engineering-bay/LED_controller/00_Docs/enclosure.jpg

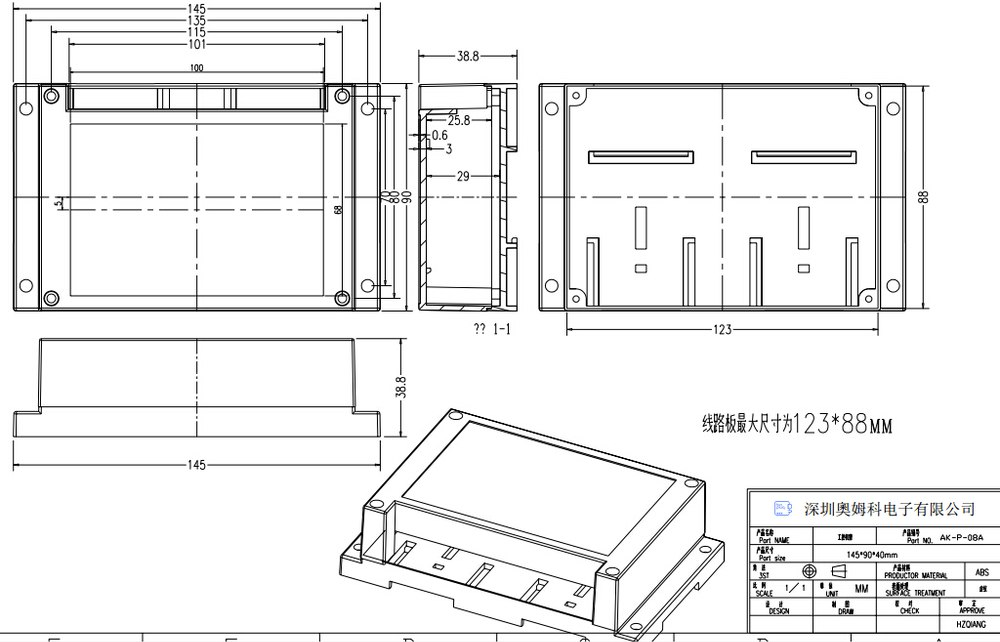
00_Docs/enclosure.jpg
