engineering-bay/LED_controller/02_Mechanics/pcb/texture_led_controller_top.png

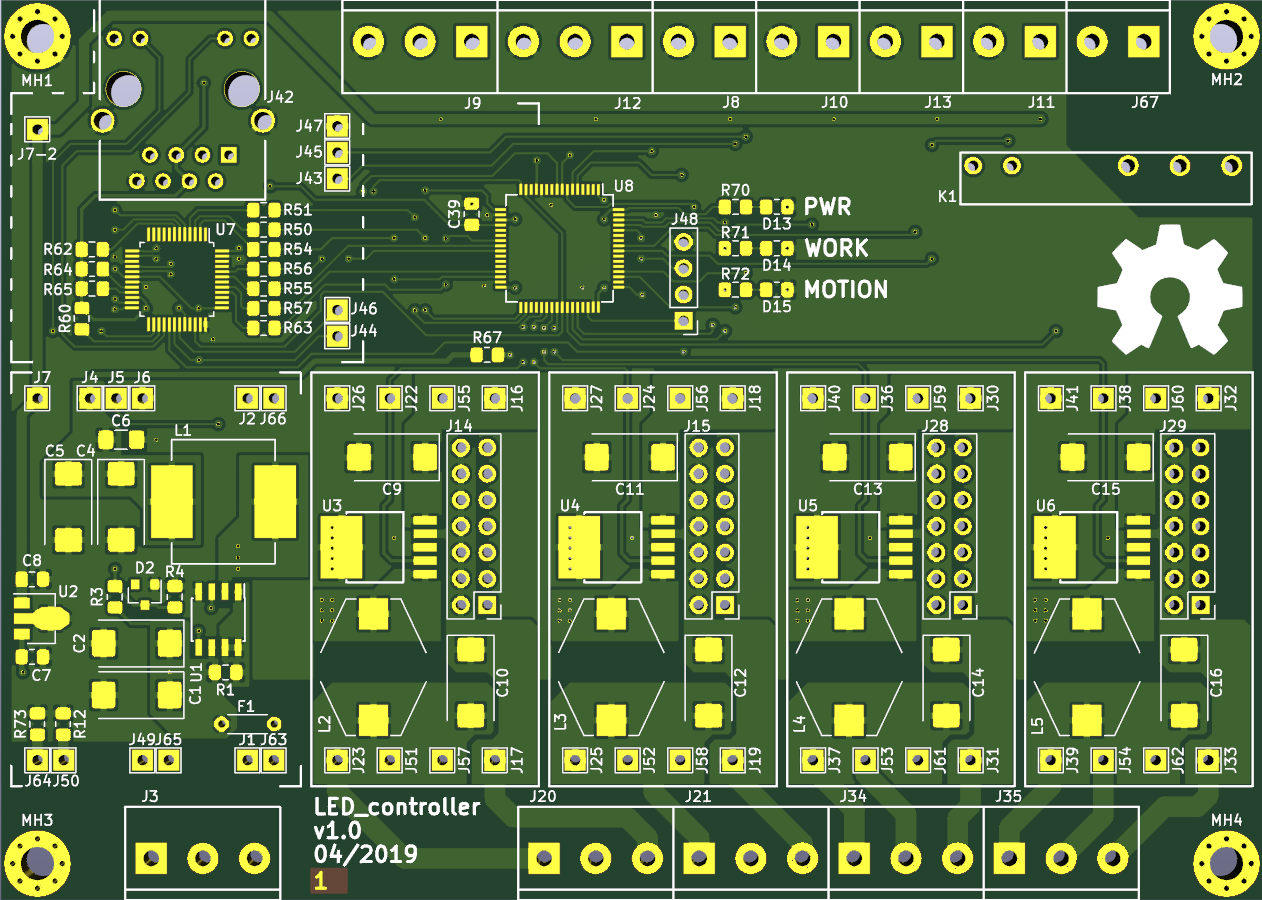
02_Mechanics/pcb/texture_led_controller_top.png
