engineering-bay/LED_controller/02_Mechanics/enclosure_top.SLDPRT

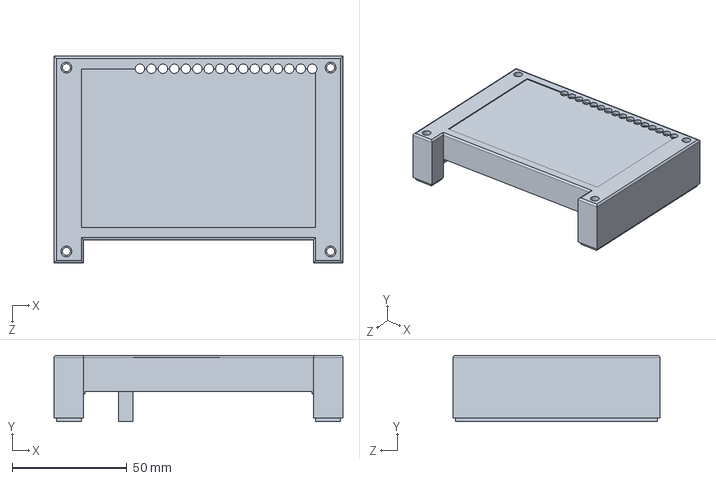
[picture p4: CAD file, 2019-04-28]
02_Mechanics/enclosure_top.SLDPRT
125.8 x 28.8 x 90.0 mm
