engineering-bay/LED_controller/02_Mechanics/enclosure_bottom.SLDPRT

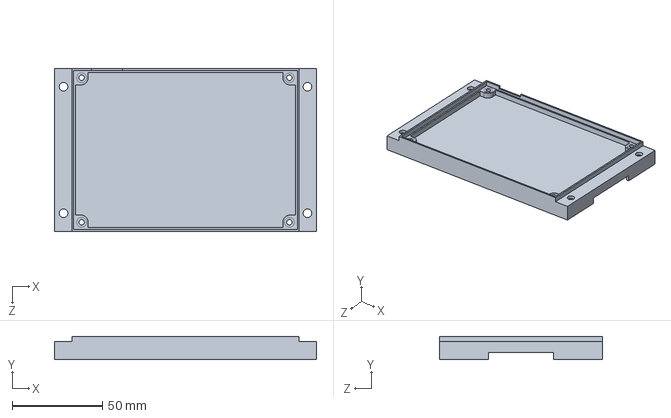
[picture p5: CAD file, 2019-04-28]
02_Mechanics/enclosure_bottom.SLDPRT
145.0 x 13.0 x 90.0 mm
