engineering-bay/LED_controller/01_Schematics/LED_controller/LED_controller.kicad_pcb

## KiCad design 01_Schematics/LED_controller/LED_controller.kicad_pcb (2019-07-31)

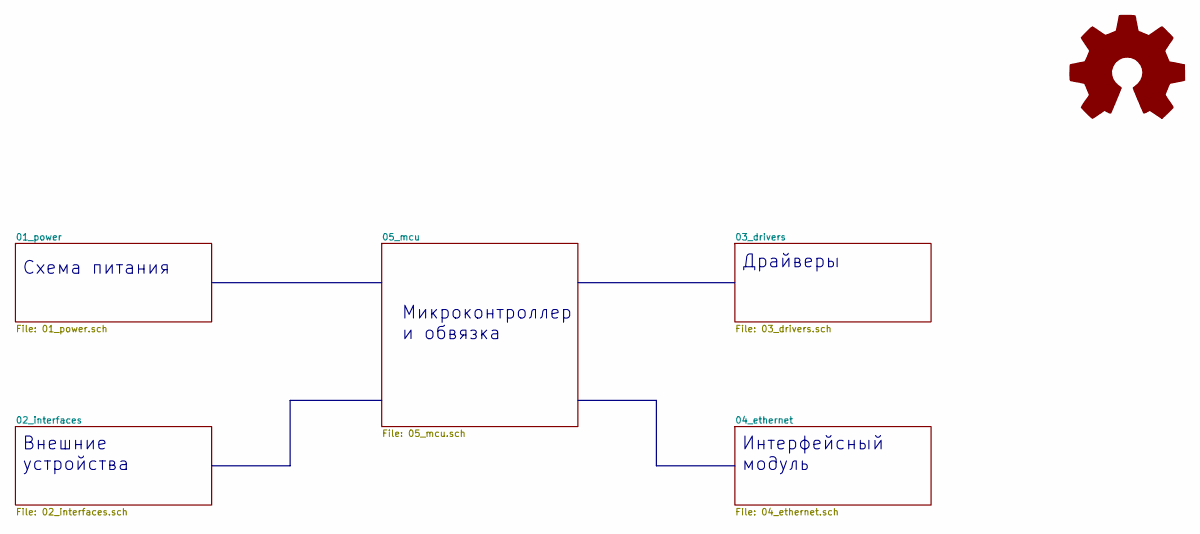
[picture p7: schematic LED_controller.sch, LED controller]

Notes on the sheet:
Схема питания
Микроконтроллер и обвязка
Внешние устройства
Интерфейсный модуль
Драйверы

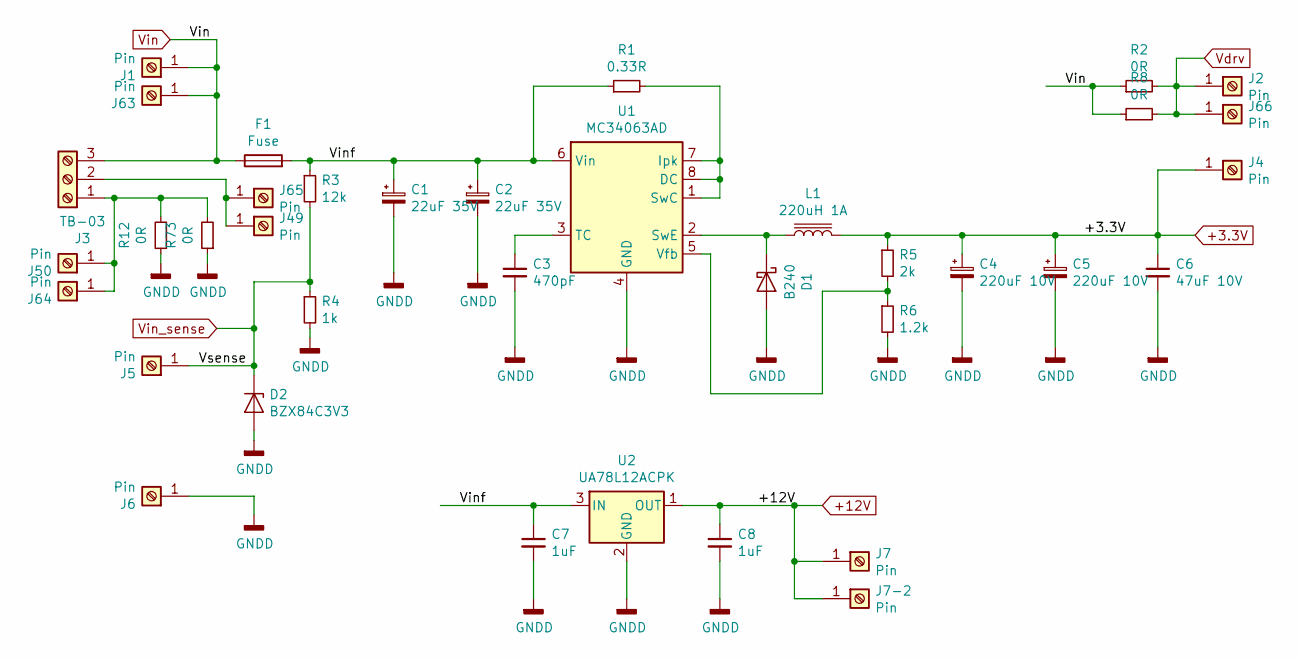
[picture p8: schematic 01_power.sch]

Parts:
C1, C2: 22uF 35V; CP_EIA-7343-31_Kemet-D_Pad2.25x2.55mm_HandSolder; partnum 293D226X9035D2TE3
C3: 470pF; C_0805_2012Metric_Pad1.15x1.40mm_HandSolder; partnum CC0805JRNPO9BN471
C4, C5: 220uF 10V; CP_EIA-7343-31_Kemet-D_Pad2.25x2.55mm_HandSolder; partnum 293D227X9010D2TE3
C6: 47uF 10V; C_1206_3216Metric_Pad1.42x1.75mm_HandSolder; partnum GRM31CR61A476ME15L
C7, C8: 1uF; C_0805_2012Metric_Pad1.15x1.40mm_HandSolder; partnum CC0805KKX7R9BB105
D1: B240; D_SMB
D2: BZX84C3V3; D_SOT-23_ANK
F1: Fuse; MF-R185; partnum MF-R090
J1, J2, J4, J5, J6, J7, J7-2, J49, J50, J63, J64, J65, J66: Pin; TestPoint_THTPad_2.0x2.0mm_Drill1.0mm
J3: TB-03; TB-03_metric; partnum TB-03
L1: 220uH 1A; SRR1208; partnum SRR1208-221KL
R1: 0.33R; R_0805_2012Metric_Pad1.15x1.40mm_HandSolder; partnum RL0805FR-070R33L
R2, R8, R12, R73: 0R; R_0805_2012Metric_Pad1.15x1.40mm_HandSolder; partnum RC2010JK-070RL
R3: 12k; R_0805_2012Metric_Pad1.15x1.40mm_HandSolder; partnum RC0805FR-0712KL
R4: 1k; R_0805_2012Metric_Pad1.15x1.40mm_HandSolder; partnum RC0805FR-071KL
R5: 2k; R_0805_2012Metric_Pad1.15x1.40mm_HandSolder; partnum RC0805FR-072KL
R6: 1.2k; R_0805_2012Metric_Pad1.15x1.40mm_HandSolder; partnum RC0805FR-071K2L
U1: MC34063AD; SOIC-8_3.9x4.9mm_P1.27mm
U2: UA78L12ACPK; SOT-89-3; partnum UA78L12ACPK

Connections:
+3.3V: C4.1, C5.1, C6.1, J4.1, L1.2, R5.1; also elsewhere on the board
+12V: C8.1, J7.1, J7-2.1, U2.1 (OUT); also elsewhere on the board
/01_power/Vinf: C1.1, C2.1, C7.1, F1.2, R1.1, R3.1, U1.6 (Vin), U2.3 (IN)
GND: C1.2, C2.2, C3.2, C4.2, C5.2, C6.2, C7.2, C8.2, D1.2 (A), D2.2 (A), J6.1, R4.2, R6.2, R12.1, R73.1, U1.4 (GND), U2.2 (GND); also elsewhere on the board
unnamed: C3.1, U1.3 (TC)
unnamed: D1.1 (K), L1.1, U1.2 (SwE)
unnamed: J3.1, J50.1, J64.1, R12.2, R73.2
unnamed: J3.2, J49.1, J65.1
unnamed: R1.2, U1.1 (SwC), U1.7 (Ipk), U1.8 (DC)
unnamed: R5.2, R6.1, U1.5 (Vfb)
Vdrv: J2.1, J66.1, R2.2, R8.2; also elsewhere on the board
Vin: F1.1, J1.1, J3.3, J63.1, R2.1, R8.1
Vin_sense: D2.1 (K), J5.1, R3.2, R4.1; also elsewhere on the board

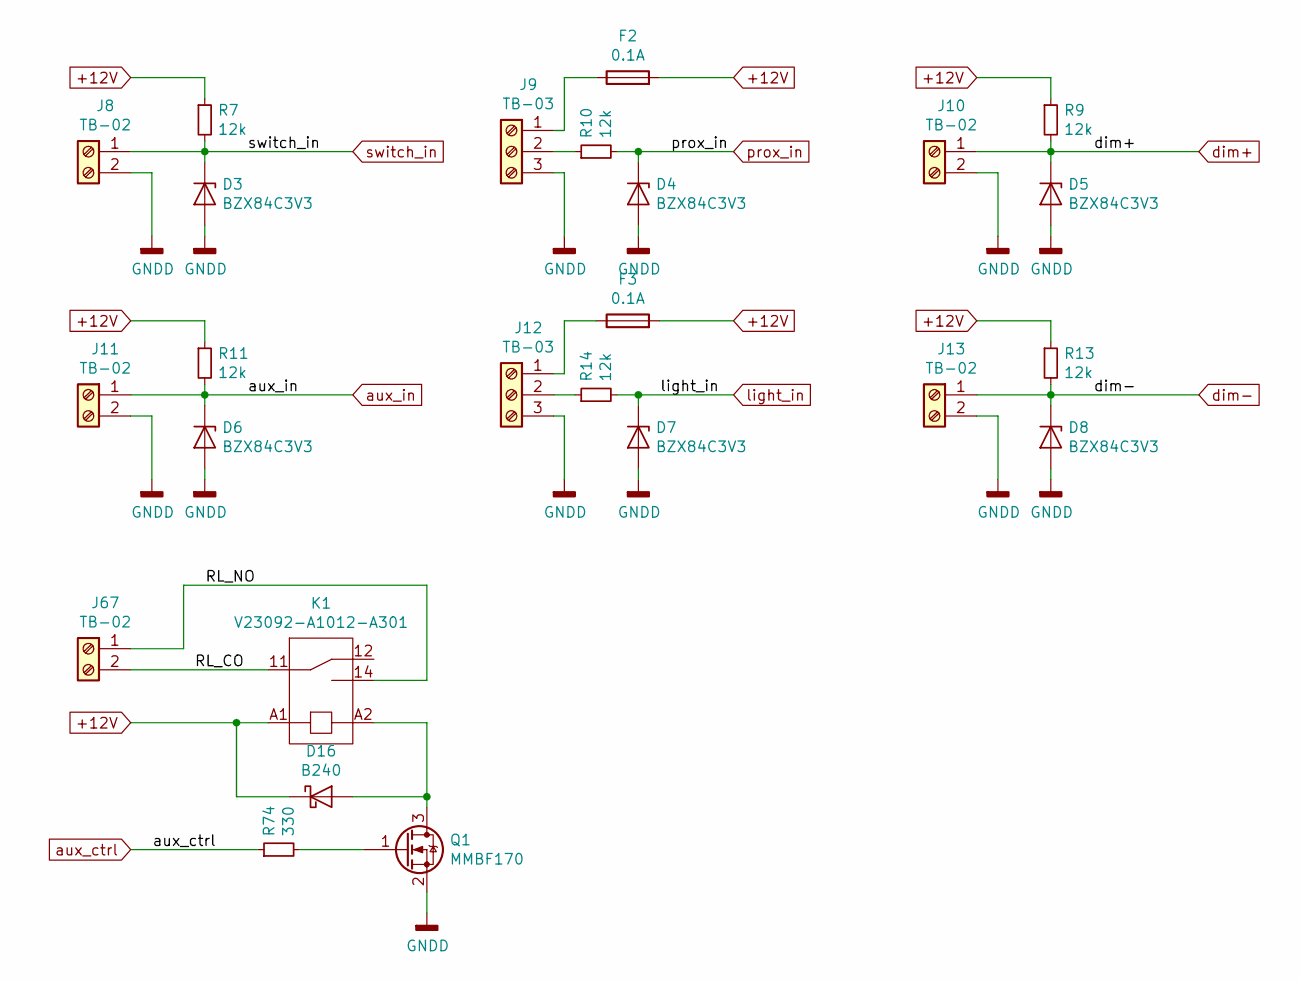
[picture p9: schematic 02_interfaces.sch]

Parts:
D3, D4, D5, D6, D7, D8: BZX84C3V3; D_SOT-23_ANK
D16: B240; D_SMB
F2, F3: 0.1A; R_1812_4532Metric_Pad1.30x3.40mm_HandSolder; partnum MF-MSMF010
J8, J10, J11, J13, J67: TB-02; TB-02_metric; partnum 300-021-12
J9, J12: TB-03; TB-03_metric; partnum 300-031-12
K1: V23092-A1012-A301; Relay_TE_V23092
Q1: MMBF170; SOT-23
R7, R9, R10, R11, R13, R14: 12k; R_0805_2012Metric_Pad1.15x1.40mm_HandSolder; partnum RC0805FR-0712KL
R74: 330; R_0805_2012Metric_Pad1.15x1.40mm_HandSolder; partnum RC0805FR-07330RL

Connections:
+12V: D16.1 (K), F2.2, F3.2, K1.A1, R7.1, R9.1, R11.1, R13.1; also elsewhere on the board
/02_interfaces/RL_CO: J67.2, K1.11
/02_interfaces/RL_NO: J67.1, K1.14
GND: D3.2 (A), D4.2 (A), D5.2 (A), D6.2 (A), D7.2 (A), D8.2 (A), J8.2, J9.3, J10.2, J11.2, J12.3, J13.2, Q1.2 (S); also elsewhere on the board
unnamed: D16.2 (A), K1.A2, Q1.3 (D)
unnamed: F2.1, J9.1
unnamed: F3.1, J12.1
unnamed: J9.2, R10.1
unnamed: J12.2, R14.1
unnamed: Q1.1 (G), R74.2
aux_ctrl: R74.1; also elsewhere on the board
aux_in: D6.1 (K), J11.1, R11.2; also elsewhere on the board
dim+: D5.1 (K), J10.1, R9.2; also elsewhere on the board
dim-: D8.1 (K), J13.1, R13.2; also elsewhere on the board
light_in: D7.1 (K), R14.2; also elsewhere on the board
prox_in: D4.1 (K), R10.2; also elsewhere on the board
switch_in: D3.1 (K), J8.1, R7.2; also elsewhere on the board

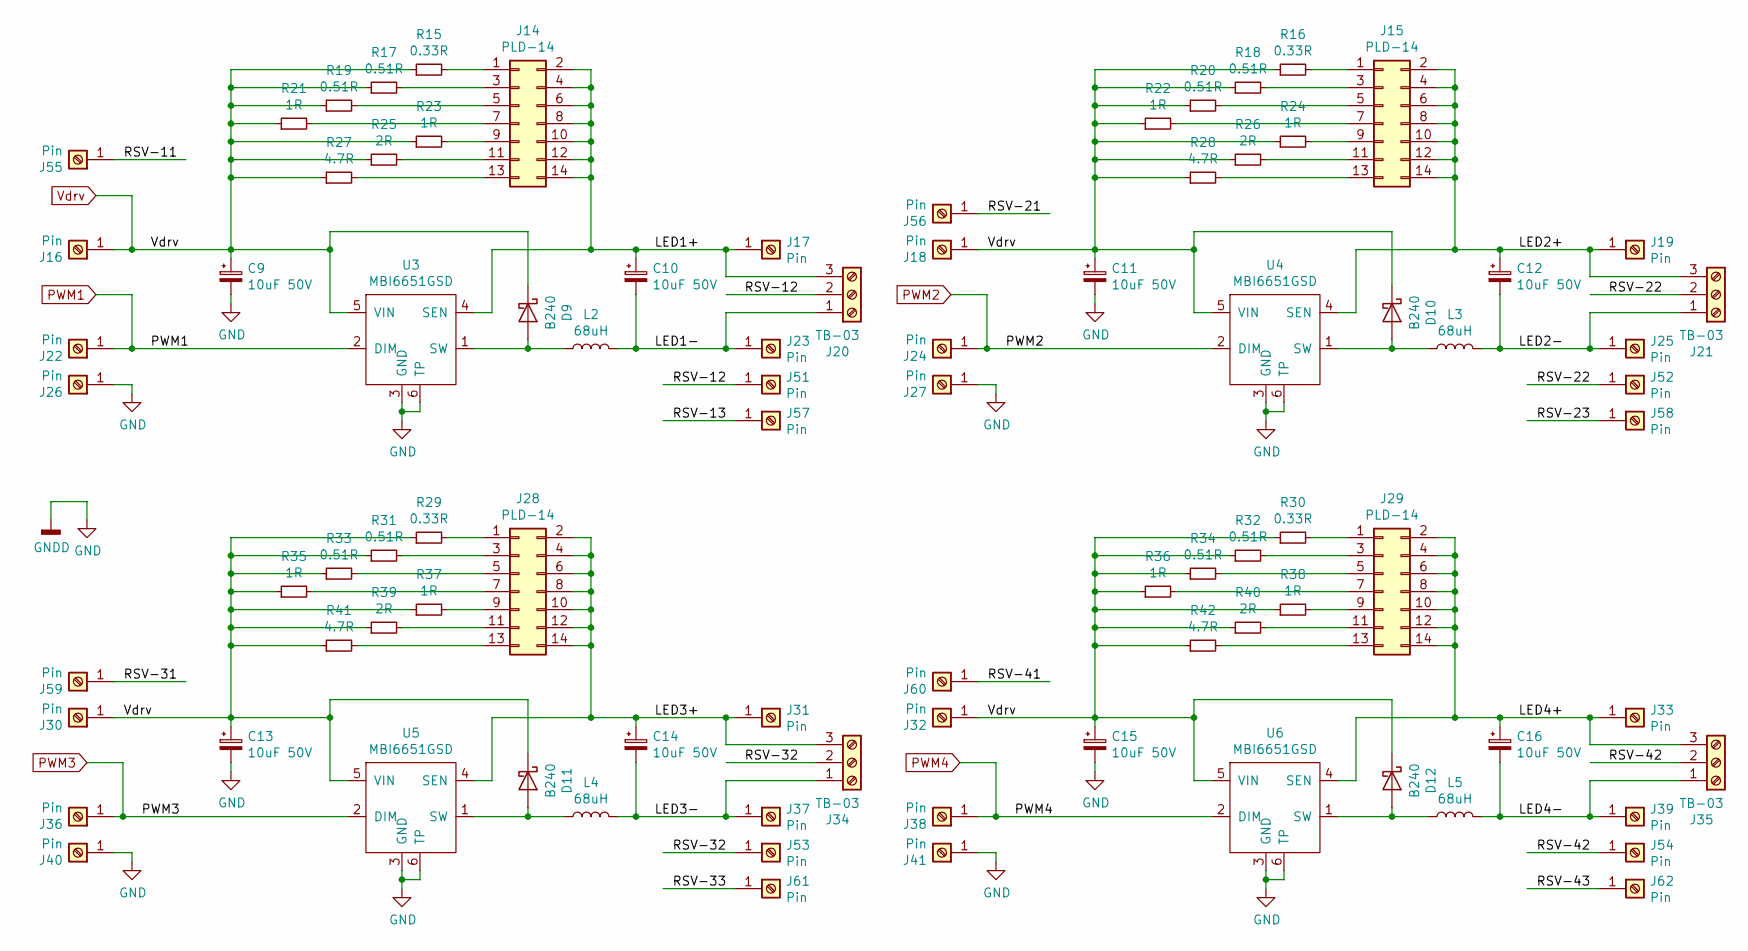
[picture p10: schematic 03_drivers.sch]

Parts:
C9, C10, C11, C12, C13, C14, C15, C16: 10uF 50V; CP_EIA-7343-31_Kemet-D_Pad2.25x2.55mm_HandSolder; partnum 293D106X9035D2TE3
D9, D10, D11, D12: B240; D_SMB
J14, J15, J28, J29: PLD-14; PinHeader_2x07_P2.54mm_Vertical; partnum PLD-14
J16, J17, J18, J19, J22, J23, J24, J25, J26, J27, J30, J31, J32, J33, J36, J37, J38, J39, J40, J41, J51, J52, J53, J54, J55, J56, J57, J58, J59, J60, J61, J62: Pin; TestPoint_THTPad_2.0x2.0mm_Drill1.0mm
J20, J21, J34, J35: TB-03; TB-03_metric; partnum TB-03
L2, L3, L4, L5: 68uH; L_Bourns-SRR1005
R15, R16, R29, R30: 0.33R; R_0805_2012Metric_Pad1.15x1.40mm_HandSolder; partnum RL0805FR-070R33L
R17, R18, R19, R20, R31, R32, R33, R34: 0.51R; R_0805_2012Metric_Pad1.15x1.40mm_HandSolder; partnum RL0805FR-070R51L
R21, R22, R23, R24, R35, R36, R37, R38: 1R; R_0805_2012Metric_Pad1.15x1.40mm_HandSolder; partnum RC0805FR-071RL
R25, R26, R39, R40: 2R; R_0805_2012Metric_Pad1.15x1.40mm_HandSolder; partnum RC0805FR-072RL
R27, R28, R41, R42: 4.7R; R_0805_2012Metric_Pad1.15x1.40mm_HandSolder; partnum RC0805FR-074R7L
U3, U4, U5, U6: MBI6651GSD; TO-252-5L; partnum MBI6651GSD-A

Connections:
/03_drivers/LED1+: C10.1, J14.2, J14.4, J14.6, J14.8, J14.10, J14.12, J14.14, J17.1, J20.3, U3.4 (SEN)
/03_drivers/LED1-: C10.2, J20.1, J23.1, L2.2
/03_drivers/LED2+: C12.1, J15.2, J15.4, J15.6, J15.8, J15.10, J15.12, J15.14, J19.1, J21.3, U4.4 (SEN)
/03_drivers/LED2-: C12.2, J21.1, J25.1, L3.2
/03_drivers/LED3+: C14.1, J28.2, J28.4, J28.6, J28.8, J28.10, J28.12, J28.14, J31.1, J34.3, U5.4 (SEN)
/03_drivers/LED3-: C14.2, J34.1, J37.1, L4.2
/03_drivers/LED4+: C16.1, J29.2, J29.4, J29.6, J29.8, J29.10, J29.12, J29.14, J33.1, J35.3, U6.4 (SEN)
/03_drivers/LED4-: C16.2, J35.1, J39.1, L5.2
/03_drivers/RSV-11: J55.1
/03_drivers/RSV-12: J20.2, J51.1
/03_drivers/RSV-13: J57.1
/03_drivers/RSV-21: J56.1
/03_drivers/RSV-22: J21.2, J52.1
/03_drivers/RSV-23: J58.1
/03_drivers/RSV-31: J59.1
/03_drivers/RSV-32: J34.2, J53.1
/03_drivers/RSV-33: J61.1
/03_drivers/RSV-41: J60.1
/03_drivers/RSV-42: J35.2, J54.1
/03_drivers/RSV-43: J62.1
GND: C9.2, C11.2, C13.2, C15.2, J26.1, J27.1, J40.1, J41.1, U3.3 (GND), U3.6 (TP), U4.3 (GND), U4.6 (TP), U5.3 (GND), U5.6 (TP), U6.3 (GND), U6.6 (TP); also elsewhere on the board
unnamed: D9.2 (A), L2.1, U3.1 (SW)
unnamed: D10.2 (A), L3.1, U4.1 (SW)
unnamed: D11.2 (A), L4.1, U5.1 (SW)
unnamed: D12.2 (A), L5.1, U6.1 (SW)
unnamed: J14.1, R15.2
unnamed: J14.3, R17.2
unnamed: J14.5, R19.2
unnamed: J14.7, R21.2
unnamed: J14.9, R23.2
unnamed: J14.11, R25.2
unnamed: J14.13, R27.2
unnamed: J15.1, R16.2
unnamed: J15.3, R18.2
unnamed: J15.5, R20.2
unnamed: J15.7, R22.2
unnamed: J15.9, R24.2
unnamed: J15.11, R26.2
unnamed: J15.13, R28.2
unnamed: J28.1, R29.2
unnamed: J28.3, R31.2
unnamed: J28.5, R33.2
unnamed: J28.7, R35.2
unnamed: J28.9, R37.2
unnamed: J28.11, R39.2
unnamed: J28.13, R41.2
unnamed: J29.1, R30.2
unnamed: J29.3, R32.2
unnamed: J29.5, R34.2
unnamed: J29.7, R36.2
unnamed: J29.9, R38.2
unnamed: J29.11, R40.2
unnamed: J29.13, R42.2
PWM1: J22.1, U3.2 (DIM); also elsewhere on the board
PWM2: J24.1, U4.2 (DIM); also elsewhere on the board
PWM3: J36.1, U5.2 (DIM); also elsewhere on the board
PWM4: J38.1, U6.2 (DIM); also elsewhere on the board
Vdrv: C9.1, C11.1, C13.1, C15.1, D9.1 (K), D10.1 (K), D11.1 (K), D12.1 (K), J16.1, J18.1, J30.1, J32.1, R15.1, R16.1, R17.1, R18.1, R19.1, R20.1, R21.1, R22.1, R23.1, R24.1, R25.1, R26.1, R27.1, R28.1, R29.1, R30.1, R31.1, R32.1, R33.1, R34.1, R35.1, R36.1, R37.1, R38.1, R39.1, R40.1, R41.1, R42.1, U3.5 (VIN), U4.5 (VIN), U5.5 (VIN), U6.5 (VIN); also elsewhere on the board

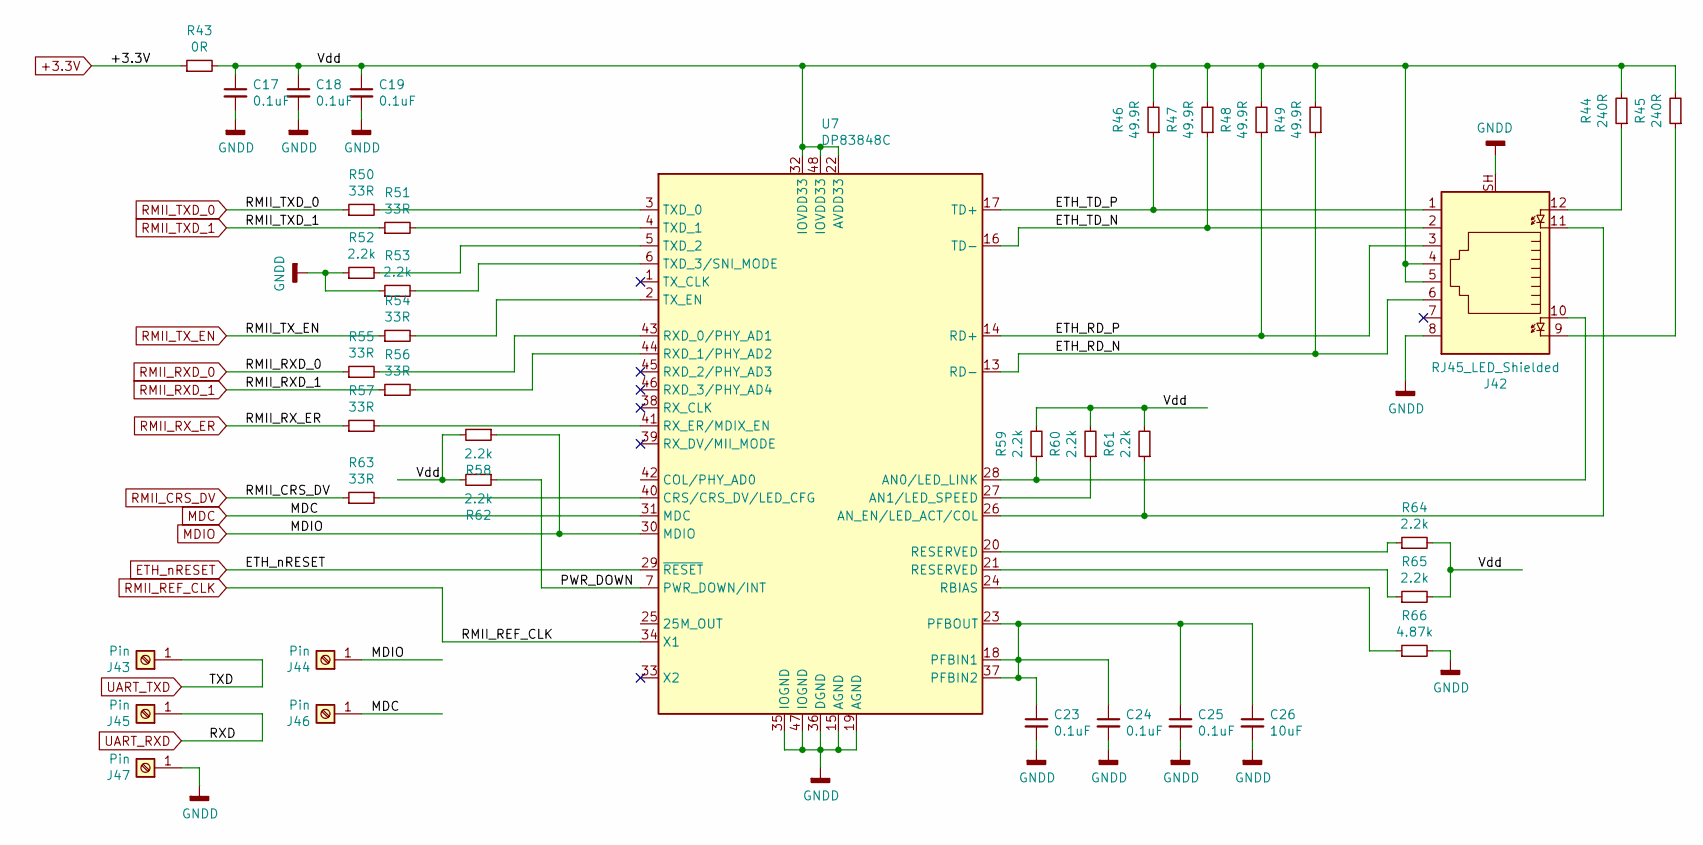
[picture p11: schematic 04_ethernet.sch]

Parts:
C17, C18, C19, C23, C24, C25: 0.1uF; C_0805_2012Metric_Pad1.15x1.40mm_HandSolder; partnum CC0805JRX7R9BB104
C26: 10uF; C_0805_2012Metric_Pad1.15x1.40mm_HandSolder; partnum GRM21BR61C106KE15L
J42: RJ45_LED_Shielded; Hanrun_HR9111105A; partnum HR911105A
J43, J44, J45, J46, J47: Pin; TestPoint_THTPad_2.0x2.0mm_Drill1.0mm
R43: 0R; R_0805_2012Metric_Pad1.15x1.40mm_HandSolder; partnum RC2010JK-070RL
R44, R45: 240R; R_0805_2012Metric_Pad1.15x1.40mm_HandSolder; partnum RC0805FR-07240RL
R46, R47, R48, R49: 49.9R; R_0805_2012Metric_Pad1.15x1.40mm_HandSolder; partnum RC0805FR-0749R9L
R50, R51, R54, R55, R56, R57, R63: 33R; R_0805_2012Metric_Pad1.15x1.40mm_HandSolder; partnum RC0805FR-0733RL
R52, R53, R58, R59, R60, R61, R62, R64, R65: 2.2k; R_0805_2012Metric_Pad1.15x1.40mm_HandSolder; partnum RC0805FR-072K2L
R66: 4.87k; R_0805_2012Metric_Pad1.15x1.40mm_HandSolder; partnum RC0805FR-074K87L
U7: DP83848C; LQFP-48_7x7mm_P0.5mm

Connections:
+3.3V: R43.1; also elsewhere on the board
/04_ethernet/ETH_RD_N: J42.6, R49.1, U7.13 (RD-)
/04_ethernet/ETH_RD_P: J42.3, R48.1, U7.14 (RD+)
/04_ethernet/ETH_TD_N: J42.2, R47.1, U7.16 (TD-)
/04_ethernet/ETH_TD_P: J42.1, R46.1, U7.17 (TD+)
/04_ethernet/PWR_DOWN: R62.1, U7.7 (PWR_DOWN/INT)
/04_ethernet/Vdd: C17.1, C18.1, C19.1, J42.4, J42.5, R43.2, R44.2, R45.2, R46.2, R47.2, R48.2, R49.2, R58.2, R59.2, R60.2, R61.2, R62.2, R64.2, R65.2, U7.22 (AVDD33), U7.32 (IOVDD33), U7.48 (IOVDD33)
ETH_nRESET: U7.29 (~RESET~); also elsewhere on the board
GND: C17.2, C18.2, C19.2, C23.2, C24.2, C25.2, C26.2, J42.8, J42.SH, J47.1, R52.1, R53.1, R66.2, U7.15 (AGND), U7.19 (AGND), U7.35 (IOGND), U7.36 (DGND), U7.47 (IOGND); also elsewhere on the board
MDC: J46.1, U7.31 (MDC); also elsewhere on the board
MDIO: J44.1, R58.1, U7.30 (MDIO); also elsewhere on the board
unnamed: C23.1, C24.1, C25.1, C26.1, U7.18 (PFBIN1), U7.23 (PFBOUT), U7.37 (PFBIN2)
unnamed: J42.9, R45.1
unnamed: J42.10, R59.1, U7.28 (AN0/LED_LINK)
unnamed: J42.11, R61.1, U7.26 (AN_EN/LED_ACT/COL)
unnamed: J42.12, R44.1
unnamed: R50.2, U7.3 (TXD_0)
unnamed: R51.2, U7.4 (TXD_1)
unnamed: R52.2, U7.5 (TXD_2)
unnamed: R53.2, U7.6 (TXD_3/SNI_MODE)
unnamed: R54.2, U7.2 (TX_EN)
unnamed: R55.2, U7.43 (RXD_0/PHY_AD1)
unnamed: R56.2, U7.44 (RXD_1/PHY_AD2)
unnamed: R57.2, U7.41 (RX_ER/MDIX_EN)
unnamed: R60.1, U7.27 (AN1/LED_SPEED)
unnamed: R63.2, U7.40 (CRS/CRS_DV/LED_CFG)
unnamed: R64.1, U7.20 (RESERVED)
unnamed: R65.1, U7.21 (RESERVED)
unnamed: R66.1, U7.24 (RBIAS)
RMII_CRS_DV: R63.1; also elsewhere on the board
RMII_REF_CLK: U7.34 (X1); also elsewhere on the board
RMII_RXD_0: R55.1; also elsewhere on the board
RMII_RXD_1: R56.1; also elsewhere on the board
RMII_RX_ER: R57.1; also elsewhere on the board
RMII_TXD_0: R50.1; also elsewhere on the board
RMII_TXD_1: R51.1; also elsewhere on the board
RMII_TX_EN: R54.1; also elsewhere on the board
UART_RXD: J45.1; also elsewhere on the board
UART_TXD: J43.1; also elsewhere on the board

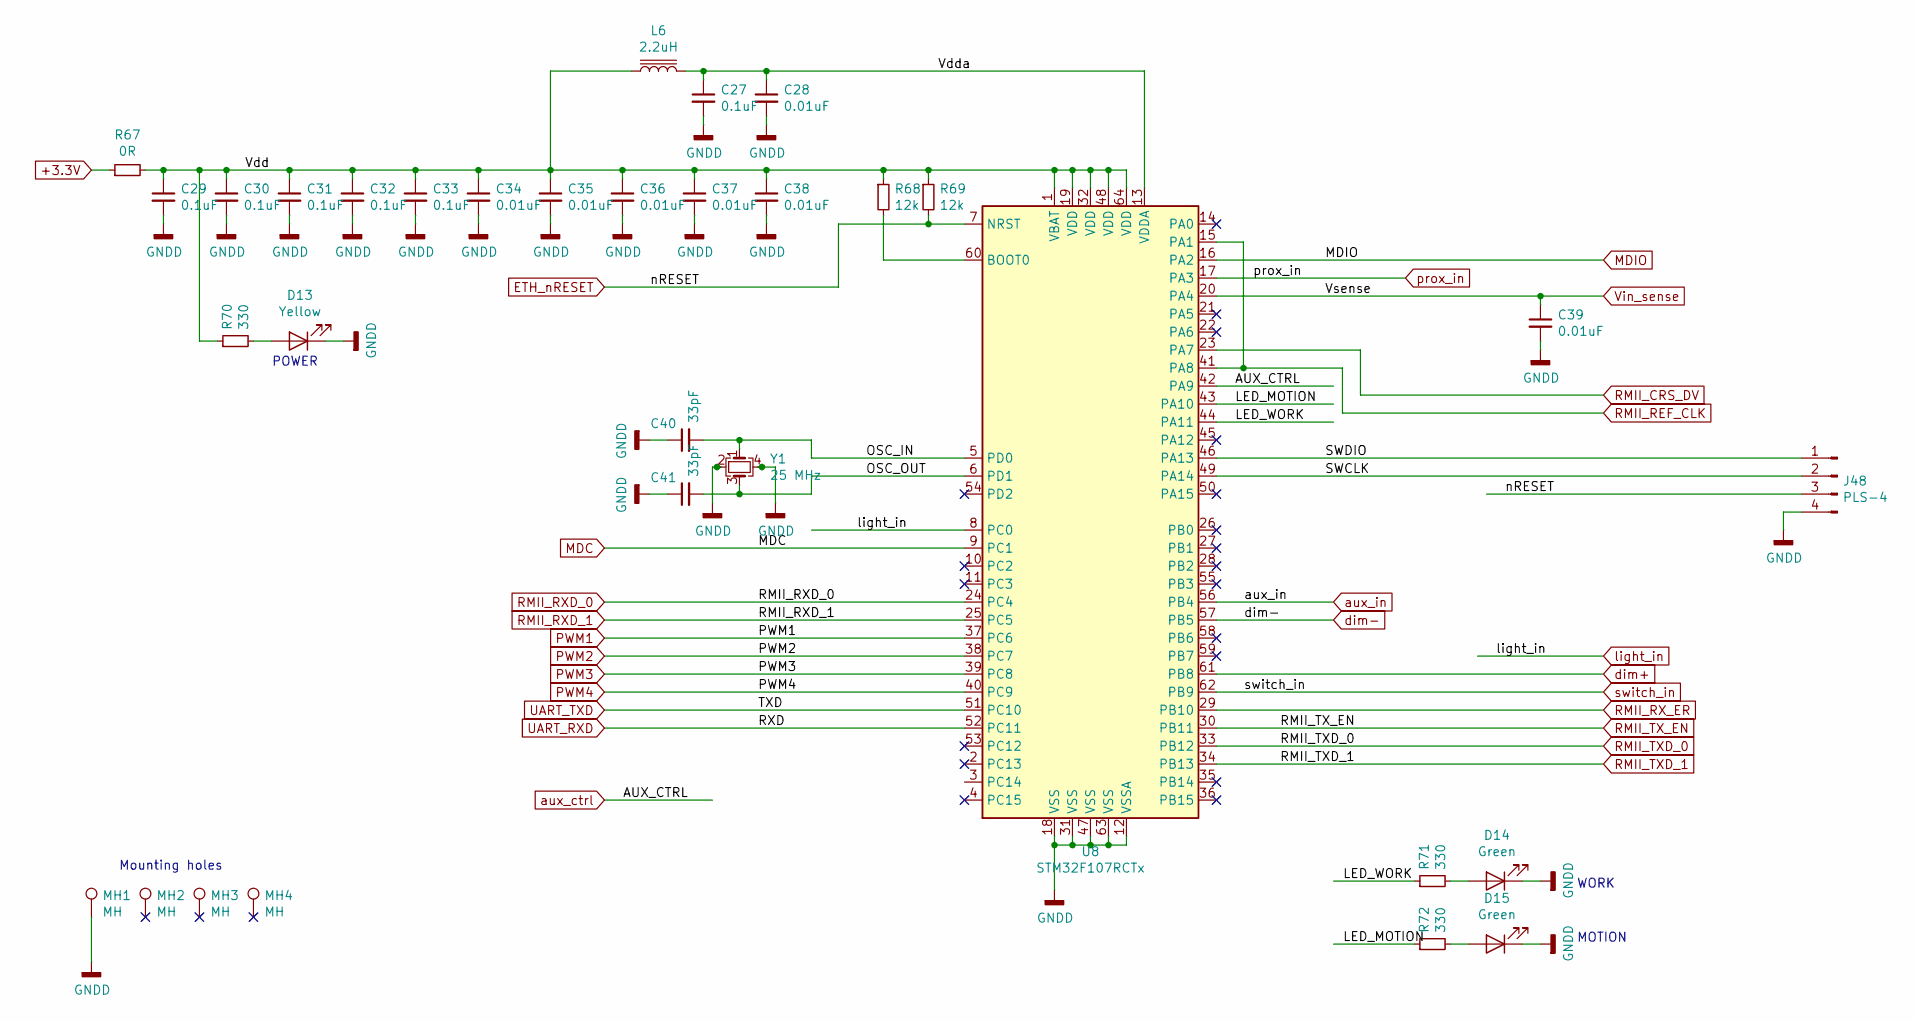
[picture p12: schematic 05_mcu.sch]

Parts:
C27, C29, C30, C31, C32, C33: 0.1uF; C_0805_2012Metric_Pad1.15x1.40mm_HandSolder; partnum CC0805JRX7R9BB104
C28, C34, C35, C36, C37, C38, C39: 0.01uF; C_0805_2012Metric_Pad1.15x1.40mm_HandSolder; partnum CC0805JRNPO9BN103
C40, C41: 33pF; C_0805_2012Metric_Pad1.15x1.40mm_HandSolder; partnum CC0805JRNPO9BN330
D13: Yellow; LED_0805_2012Metric_HandSolder; partnum TO-2013BC-MYF
D14, D15: Green; LED_0805_2012Metric_HandSolder; partnum TO-2013BC-PG
J48: PLS-4; PinHeader_1x04_P2.54mm_Vertical; partnum PLS-4
L6: 2.2uH; L_0805_2012Metric_Pad1.15x1.40mm_HandSolder; partnum B82498F1222J000
MH1, MH2, MH3, MH4: MH; MountingHole_3.2mm_M3_Pad_Via
R67: 0R; R_0805_2012Metric_Pad1.15x1.40mm_HandSolder; partnum RC2010JK-070RL
R68, R69: 12k; R_0805_2012Metric_Pad1.15x1.40mm_HandSolder; partnum RC0805FR-0712KL
R70, R71, R72: 330; R_0805_2012Metric_Pad1.15x1.40mm_HandSolder; partnum RC0805FR-07330RL
U8: STM32F107RCTx; LQFP-64_10x10mm_P0.5mm; partnum STM32F107RCTx
Y1: 25 MHz; Crystal_SMD_3225-4Pin_3.2x2.5mm_HandSoldering; partnum KX-7 25.0 MHz

Connections:
+3.3V: R67.1; also elsewhere on the board
/05_mcu/LED_MOTION: R72.1, U8.43 (PA10)
/05_mcu/LED_WORK: R71.1, U8.44 (PA11)
/05_mcu/OSC_IN: C40.2, U8.5 (PD0), Y1.1
/05_mcu/OSC_OUT: C41.2, U8.6 (PD1), Y1.3
/05_mcu/SWCLK: J48.2, U8.49 (PA14)
/05_mcu/SWDIO: J48.1, U8.46 (PA13)
/05_mcu/Vdd: C29.1, C30.1, C31.1, C32.1, C33.1, C34.1, C35.1, C36.1, C37.1, C38.1, L6.1, R67.2, R68.1, R69.1, R70.1, U8.1 (VBAT), U8.19 (VDD), U8.32 (VDD), U8.48 (VDD), U8.64 (VDD)
/05_mcu/Vdda: C27.1, C28.1, L6.2, U8.13 (VDDA)
ETH_nRESET: J48.3, R69.2, U8.7 (NRST); also elsewhere on the board
GND: C27.2, C28.2, C29.2, C30.2, C31.2, C32.2, C33.2, C34.2, C35.2, C36.2, C37.2, C38.2, C39.2, C40.1, C41.1, D13.1 (K), D14.1 (K), D15.1 (K), J48.4, MH1.1, U8.12 (VSSA), U8.18 (VSS), U8.31 (VSS), U8.47 (VSS), U8.63 (VSS), Y1.2, Y1.4; also elsewhere on the board
MDC: U8.9 (PC1); also elsewhere on the board
MDIO: U8.16 (PA2); also elsewhere on the board
unnamed: D13.2 (A), R70.2
unnamed: D14.2 (A), R71.2
unnamed: D15.2 (A), R72.2
unnamed: R68.2, U8.60 (BOOT0)
PWM1: U8.37 (PC6); also elsewhere on the board
PWM2: U8.38 (PC7); also elsewhere on the board
PWM3: U8.39 (PC8); also elsewhere on the board
PWM4: U8.40 (PC9); also elsewhere on the board
RMII_CRS_DV: U8.23 (PA7); also elsewhere on the board
RMII_REF_CLK: U8.15 (PA1), U8.41 (PA8); also elsewhere on the board
RMII_RXD_0: U8.24 (PC4); also elsewhere on the board
RMII_RXD_1: U8.25 (PC5); also elsewhere on the board
RMII_RX_ER: U8.29 (PB10); also elsewhere on the board
RMII_TXD_0: U8.33 (PB12); also elsewhere on the board
RMII_TXD_1: U8.34 (PB13); also elsewhere on the board
RMII_TX_EN: U8.30 (PB11); also elsewhere on the board
UART_RXD: U8.52 (PC11); also elsewhere on the board
UART_TXD: U8.51 (PC10); also elsewhere on the board
Vin_sense: C39.1, U8.20 (PA4); also elsewhere on the board
aux_ctrl: U8.42 (PA9); also elsewhere on the board
aux_in: U8.56 (PB4); also elsewhere on the board
dim+: U8.61 (PB8); also elsewhere on the board
dim-: U8.57 (PB5); also elsewhere on the board
light_in: U8.8 (PC0); also elsewhere on the board
prox_in: U8.17 (PA3); also elsewhere on the board
switch_in: U8.62 (PB9); also elsewhere on the board

Notes on the sheet:
POWER
WORK
MOTION
Mounting holes

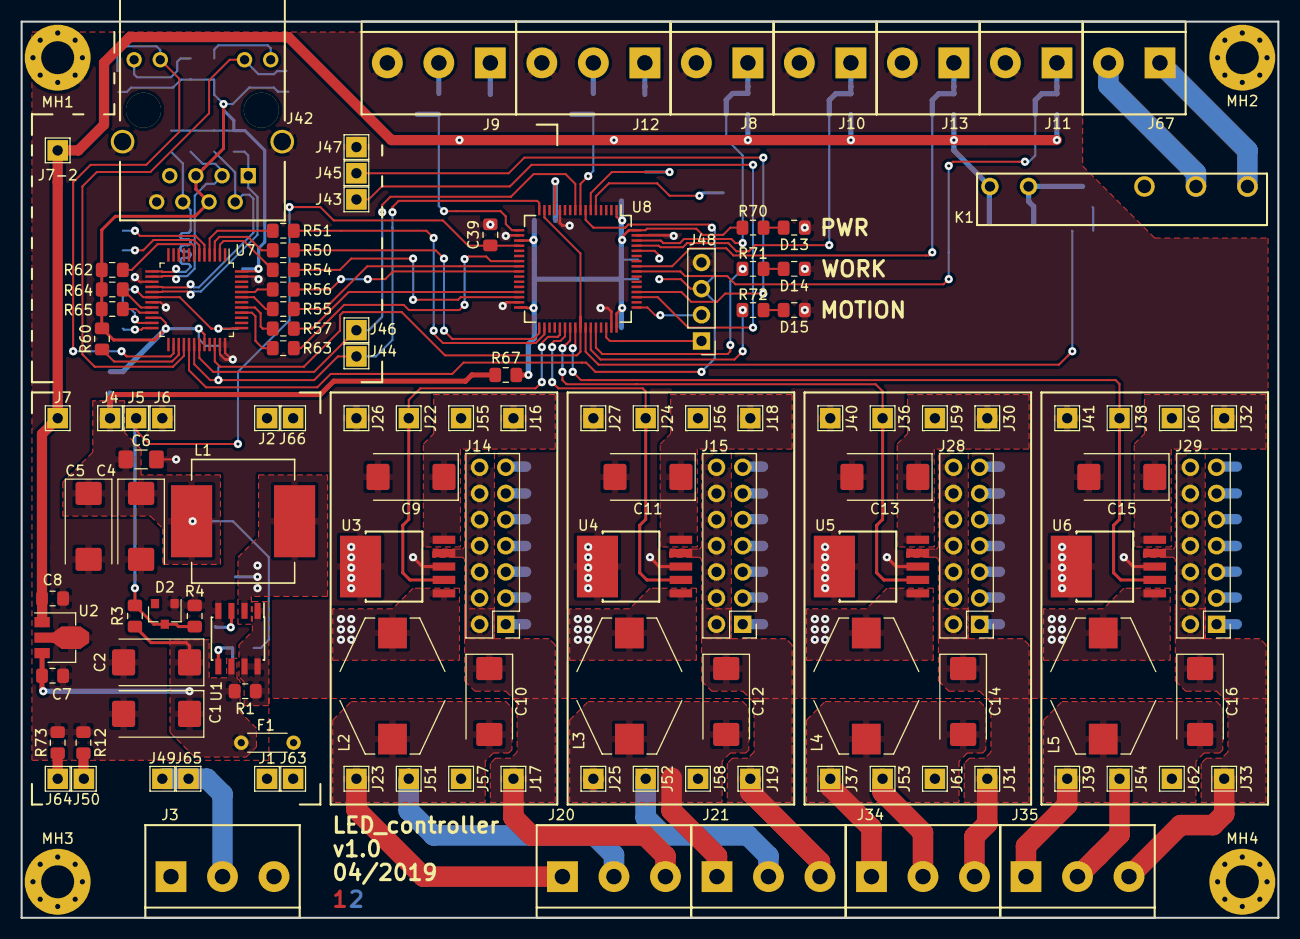
[picture p13: board LED_controller.kicad_pcb from above]

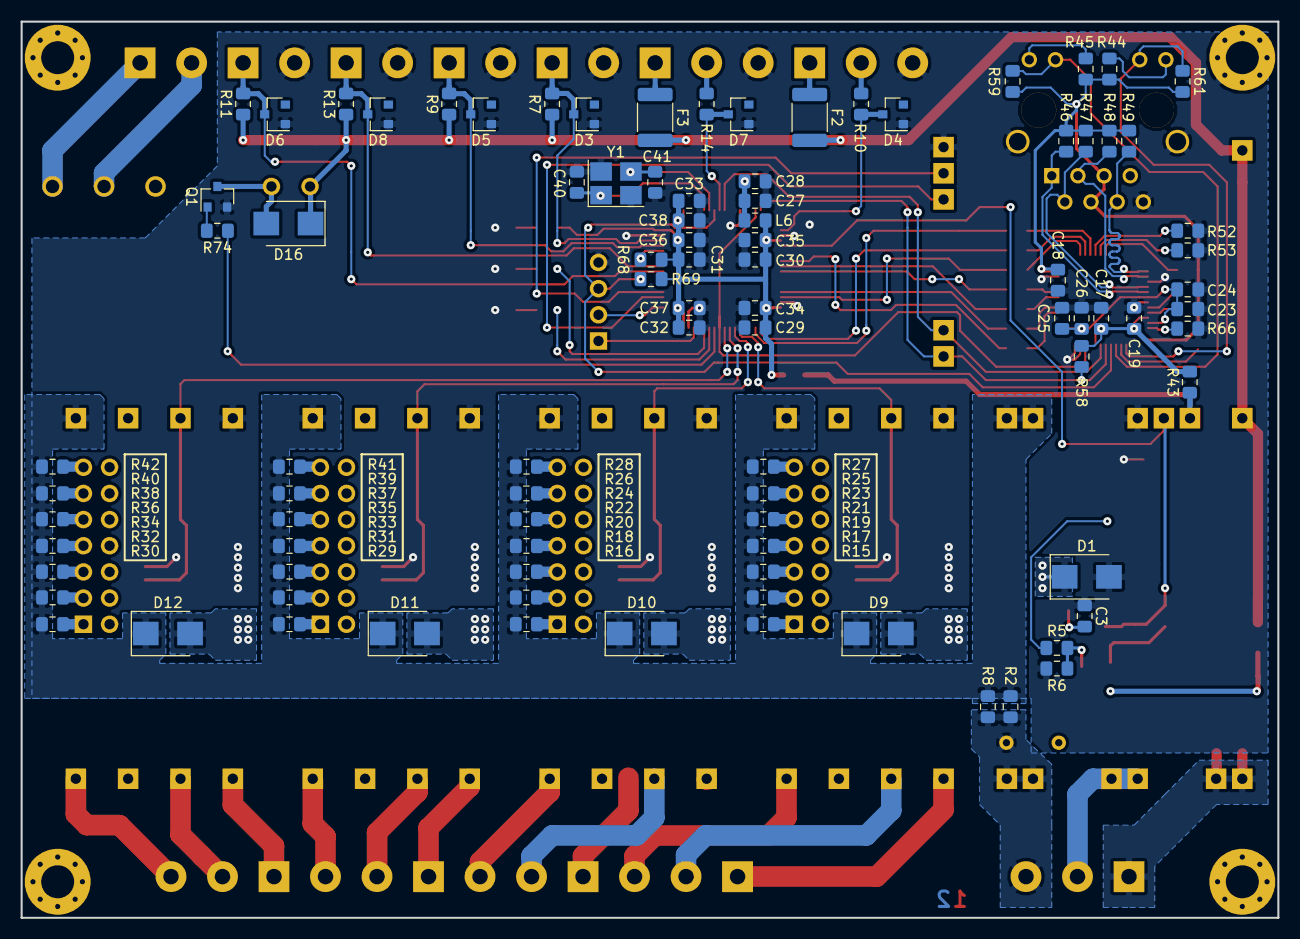
[picture p14: board LED_controller.kicad_pcb from below]

Board: 2 copper layers, 122.0 x 87.0 mm, 220 parts (93 on the bottom side), 125 nets.
