engineering-bay/LED_controller/(commit log)

2018-12-20 Добавлено: - Схема электрическая; - Библиотека extras (всё, чего не было в стандартных библиотеках); - даташиты на компоненты.
    [01_power.sch, 02_interfaces.sch, 03_drivers.sch, 04_ethernet.sch, 05_mcu.sch, LED_controller.sch]
2019-04-28 - Добавлена печатная плата; - Добавлены файлы посадочных мест использованных компонентов и STEP модели; - Добавлены файлы механической сборки (Solidworks);
    [01_power.sch, 02_interfaces.sch, 03_drivers.sch, 04_ethernet.sch, 05_mcu.sch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]
2019-07-31 - Исправлена ошибка с неправильным подключением цепи обратной связи микросхемы U1; - Плата переразведена с учетом изменений в схеме; - Добавлен файл BOM;
    [01_power.sch, 05_mcu.sch, LED_controller.kicad_pcb]
